biocompute-inc/Bandara_circuit_revamped/(commit log)

2025-10-13 cleaning up the setup
    [Bandara_revamped_version_0.1.0.kicad_sch]
2025-10-14 TIA added to the circuit
    [Bandara_revamped_version_0.1.0.kicad_sch]
2025-10-14 inverting amp added
    [Bandara_revamped_version_0.1.0.kicad_sch]
2025-10-15 filter added
    [Bandara_revamped_version_0.1.0.kicad_sch]
2025-10-15 Power Supply Added
    [Bandara_revamped_version_0.1.0.kicad_sch]
2025-10-15 HVamp added, review not done
    [Bandara_revamped_version_0.1.0.kicad_sch]
2025-10-16 Create README.md for Bandara Circuit redesign
    Added initial README for Bandara Circuit project.
